secplay666/zhaohuiCatToilet/hardware/软硬件接口说明.xlsx

Sheet: 封面
自动猫砂盆主板软硬件接口
 | V2.0 20240901

Sheet: Sheet1
Pin No. | Name | RTC | ADC/DAC | SPI | function | Usage | ESP-WROOM-32
1 | GND1 |  |  |  | GND | GND
2 | 3V3 |  |  |  | POWER | POWER
3 | EN |  |  |  | RESET_N | RESET_N
4 | IO36/SENSOR_VP | Y | ADC1 |  | input only | 电流反馈(ADC) |  | P26
5 | IO39/SENSOR_VN | Y | ADC1 |  | input only | 热释电红外传感器 | 红外传感器 | P5
6 | IO34 | Y | ADC1 |  | input only | 红外开关1 |  | CN4
7 | IO35 | Y | ADC1 |  | input only | 预留开关4 |  | P22
8 | IO32 | Y | ADC1 |  |  | motor PWM1 |  | P6
9 | IO33 | Y | ADC1 |  |  | motor PWM2 |  | P7
10 | IO25 | Y | ADC2/DAC1 |  |  | 灯光2 |  | P16
11 | IO26 | Y | ADC2/DAC2 |  |  | 预留开关1 |  | P10
12 | IO27 | Y | ADC2 |  |  | 限位开关2 |  | P9
13 | IO14/MTMS | Y | ADC2 | HSPICLK | JTAG | JTAG |  | P19
14 | IO12/MTDI | Y | ADC2 | HSPIQ | JTAG | JTAG |  | P19
15 | GND2 |  |  |  | GND | GND
16 | IO13/MTCK | Y | ADC2 | HSPID | JTAG | JTAG |  | P19
17 | SHD/SD2 |  |  | SPIHD | FLASH | 模块内FLASH
18 | SWP/SD3 |  |  | SPIWP | FLASH | 模块内FLASH
19 | SCS/CMD |  |  | SPICS0 | FLASH | 模块内FLASH
20 | SCK/CLK |  |  | SPICLK | FLASH | 模块内FLASH
21 | SDO/SD0 |  |  | SPIQ | FLASH | 模块内FLASH
22 | SDI/SD1 |  |  | SPID | FLASH | 模块内FLASH
23 | IO15/MTDO | Y | ADC2 | HSPICS0 | JTAG | JTAG |  | P19
24 | IO2 | Y | ADC2 | HSPIWP | 5K pulldown for boot | BOOT OPTION |  | LED1
25 | IO0 | Y | ADC2 |  | BOOT OPTION | BOOT OPTION |  | P1
26 | IO4 | Y | ADC2 | HSPIHD |  | 限位开关1 |  | P8
27 | IO16 |  |  |  |  | HX711 SCK
28 | IO17 |  |  |  |  | HX711 DT
29 | IO5 |  |  | VSPICS0 | TM1638 STB | 预留开关2 |  | P20
30 | IO18 |  |  | VSPICLK | TM1638 CLK | 灯光1 |  | P14
31 | IO19 |  |  | VSPIQ |  | 灯光3 |  | P18
32 | NC |  |  |  | NC | NC
33 | IO21 |  |  | VSPIHD |  | 预留开关3 |  | P21
34 | RXD0 |  |  |  | UART0RX | UART |  | P2
35 | TXD0 |  |  |  | UART0TX | UART |  | P2
36 | IO22 |  |  | VSPIWP |  | 红外开关2 |  | CN5
37 | IO23 |  |  | VSPID | TM1638 DIO | 预留开关5 |  | P23
38 | GND3 |  |  |  | GND | GND
39 | P_GND |  |  |  | GND | GND
Comments:
Strapping 管脚：GPIO0、GPIO2、GPIO5、GPIO12 (MTDI) 和 GPIO15 (MTDO) 是 Strapping 管脚。更多信息请参考 ESP32 技术规格书。 (https://www.espressif.com/sites/default/files/documentation/esp32_datasheet_cn.pdf)
SPI0/1：GPIO6-11 和 GPIO16-17 通常连接到模组内集成的 SPI flash 和 PSRAM，因此不能用于其他用途。
JTAG：GPIO12-15 通常用于在线调试。
GPI：GPIO34-39 只能设置为输入模式，不具备软件使能的上拉或下拉功能。
TXD & RXD 通常用于烧录和调试。
ADC2：使用 Wi-Fi 时不能使用 ADC2 管脚。因此，如果您在使用 Wi-Fi 时无法从 ADC2 GPIO 获取值，可以考虑使用 ADC1 GPIO 来解决该问题。更多详情请参考 ADC 连续转换模式下的硬件限制 以及 ADC 单次转换模式下的硬件限制。
使用 ADC 或睡眠模式下使用 Wi-Fi 和蓝牙时，请不要使用 GPIO36 和 GPIO39 的中断。有关问题的详细描述，请参考 ESP32 ECO 和 Bug 解决方法 > 中的第 3.11 节。 (https://espressif.com/sites/default/files/documentation/eco_and_workarounds_for_bugs_in_esp32_cn.pdf)
