secplay666/zhaohuiCatToilet/(list of files, drawings)

Other design files:
hardware/MSP1/Core.SchDoc
hardware/MSP1/IO2.SchDoc
hardware/MSP1/IO.SchDoc
hardware/MSP1/MSP1.PrjPcb
hardware/MSP1/PCB1.PcbDoc
hardware/MSP1/PCB2.PcbDoc
hardware/MSP1/Power.SchDoc
hardware/MSP1/Sensor.SchDoc
hardware/MSP1/Sheet1.SchDoc
