secplay666/zhaohuiCatToilet/firmware/main/main.c

#include "freertos/FreeRTOS.h"
#include "freertos/task.h"
#include "esp_event.h"
#include "esp_netif.h"
#include "esp_log.h"
#include "lwip/sockets.h"

#include "tcp_server.h"
#include "TM1638_driver.h"
#include "drv8871_driver.h"
#include "hx711_driver.h"
#include "motor.h"
#include "command.h"
#include "connect.h"
#include "config.h"

static const char *TAG = "main";

void app_main(void)
{
    /* Initialize NVS partition */
    esp_err_t ret = nvs_flash_init();
    if (ret == ESP_ERR_NVS_NO_FREE_PAGES || ret == ESP_ERR_NVS_NEW_VERSION_FOUND) {
        /* NVS partition was truncated
         * and needs to be erased */
        ESP_ERROR_CHECK(nvs_flash_erase());

        /* Retry nvs_flash_init */
        ESP_ERROR_CHECK(nvs_flash_init());
    }

    ESP_ERROR_CHECK(config_init());

    ESP_ERROR_CHECK(command_init());
    ESP_ERROR_CHECK(esp_event_loop_create_default());

    //ESP_ERROR_CHECK(TM1638_init());
    ESP_ERROR_CHECK(DRV8871_init());

    // start ip layer
    ESP_ERROR_CHECK(esp_netif_init());
    
    // start wifi connection (we use wifi provisioning instead)
    ESP_ERROR_CHECK(wifi_connect());

    xTaskCreate(motor_task, "motor", 4096, NULL, 5, NULL);
    xTaskCreate(HX711_task, "weight", 4096, NULL, 5, NULL);

    // start UART console
    xTaskCreate(command_task, "command", 4096, NULL, 5, NULL);

#ifdef CONFIG_IPV4
    xTaskCreate(tcp_server_task, "tcp_server", 4096, (void*)AF_INET, 5, NULL);
#endif
#ifdef CONFIG_IPV6
    xTaskCreate(tcp_server_task, "tcp_server", 4096, (void*)AF_INET6, 5, NULL);
#endif

    ESP_ERROR_CHECK(motor_auto_process());

}
