secplay666/zhaohuiCatToilet/firmware/main/drv8871_driver.h

#ifndef DRV8871_DRIVER_H
#define DRV8871_DRIVER_H

#include "esp_err.h"

//#define DRV8871_A      CONFIG_DRV8871_A
//#define DRV8871_B      CONFIG_DRV8871_B

//extern const uint8_t DRV8871_char_table[];

//#define SPEED_STEP 5

esp_err_t DRV8871_init(void);

esp_err_t DRV8871_set_speed(int speed);
int DRV8871_get_speed();
//esp_err_t DRV8871_speed_up(void);
//esp_err_t DRV8871_speed_down(void);

esp_err_t DRV8871_forward(void);
esp_err_t DRV8871_reverse(void);
esp_err_t DRV8871_forward_brake(void);
esp_err_t DRV8871_reverse_brake(void);

esp_err_t DRV8871_coast(void);
esp_err_t DRV8871_brake(void);

//direction settings
void DRV8871_set_direction(bool inversed);

#endif
