secplay666/zhaohuiCatToilet/(commit log)

2024-06-29 simple handling of Hx711 Error
    [hx711_driver.c, hx711_driver.h]
2024-07-03 fix uart driver bug
    [command.c, drv8871_driver.c, hx711_driver.c, tcp_server.c]
2024-07-06 use linenoise to handle UART console, fix HX711 and tcp_server
    [command.c, hx711_driver.c, tcp_server.c]
2024-07-06 rework motor control logic
    [TM1638_driver.c, command.c, drv8871_driver.c, drv8871_driver.h, hx711_driver.c, main.c, motor.c, motor.h]
2024-07-14 add vfs driver template to duplicate socket fds
    add redirection to HX711 data output
    shutdown socket gracefully in tcp_server.c
    update oscilloscope app to work with firmware
2024-07-21 add an motor action state machine for cleaning and homing action
2024-07-26 add nvs config module, do nvs auto-refresh at poweron
2024-08-14 add config parameters for motor control
2024-08-25 add network version of Oscilliscope
    change shutdown socket procedure
2024-09-06 new feature: wifi provisioning
    [partitions.csv]
2024-09-07 Update hardware
    [Core.SchDoc, IO.SchDoc, IO2.SchDoc, MSP1.PrjPcb, PCB1.PcbDoc, Power.SchDoc, Sensor.SchDoc, Sheet1.SchDoc]
2024-09-22 update pcb2
    [Core.SchDoc, IO.SchDoc, IO2.SchDoc, MSP1.PrjPcb, PCB1.PcbDoc, PCB2.PcbDoc, Power.SchDoc, Sensor.SchDoc]
2024-10-05 update hardware PCB2
    [Core.SchDoc, IO.SchDoc, IO2.SchDoc, MSP1.PrjPcb, 软硬件接口说明.xlsx]
